kookic/VAL-2000/Media/cap-buttons-bottom.jpg

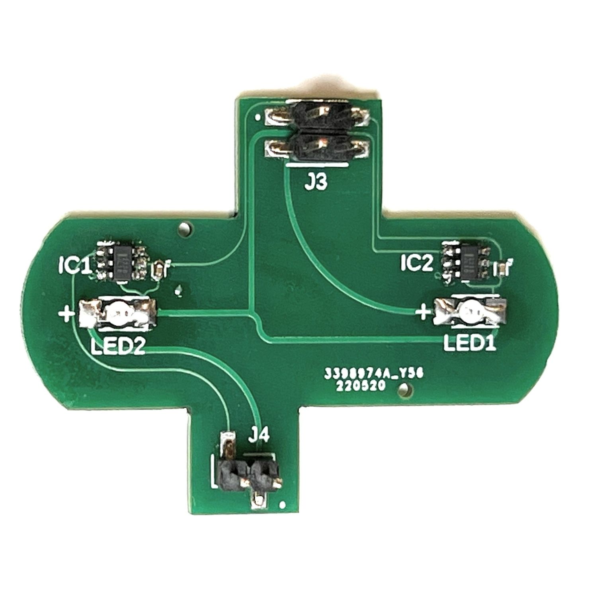
Media/cap-buttons-bottom.jpg
