kookic/VAL-2000/Media/cap-buttons-mounted-2.jpg

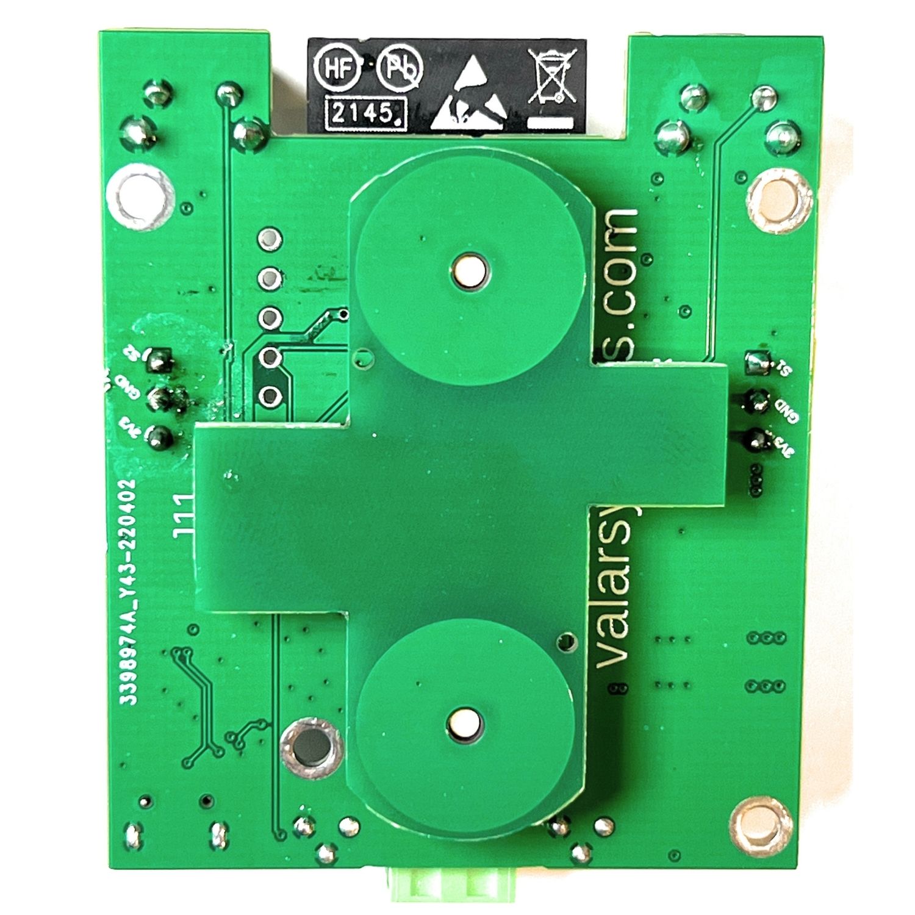
Media/cap-buttons-mounted-2.jpg
