kookic/VAL-2000/Media/cap-buttons-mounted.jpg

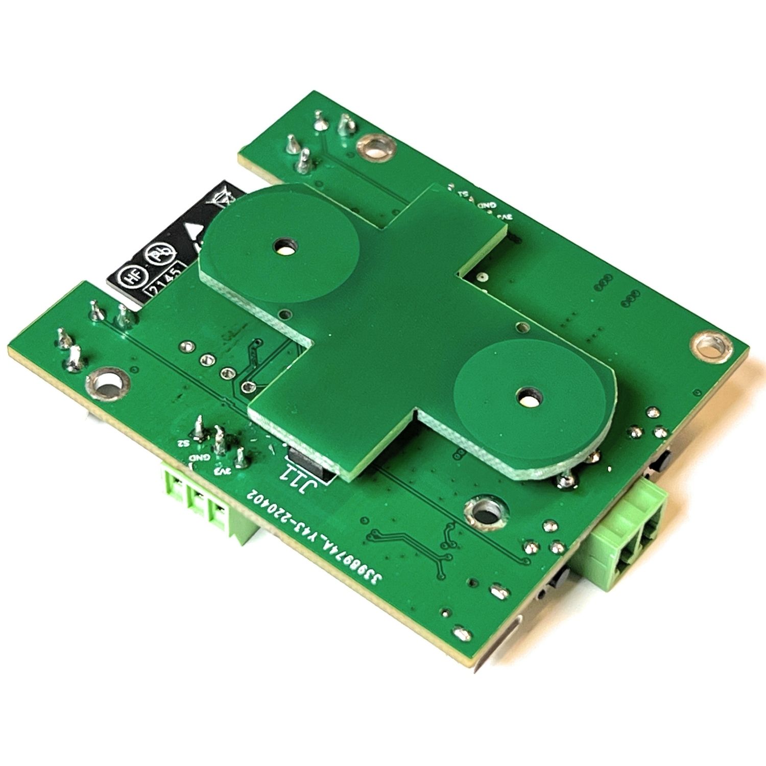
Media/cap-buttons-mounted.jpg
