kookic/VAL-2000/Media/VAL-2000-top.jpg

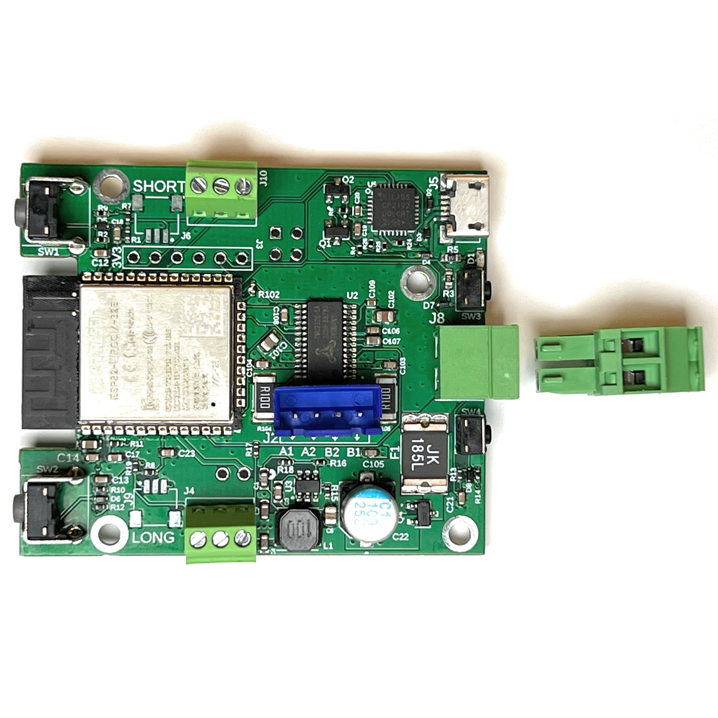
Media/VAL-2000-top.jpg
