kookic/VAL-2000/Schematic.pdf

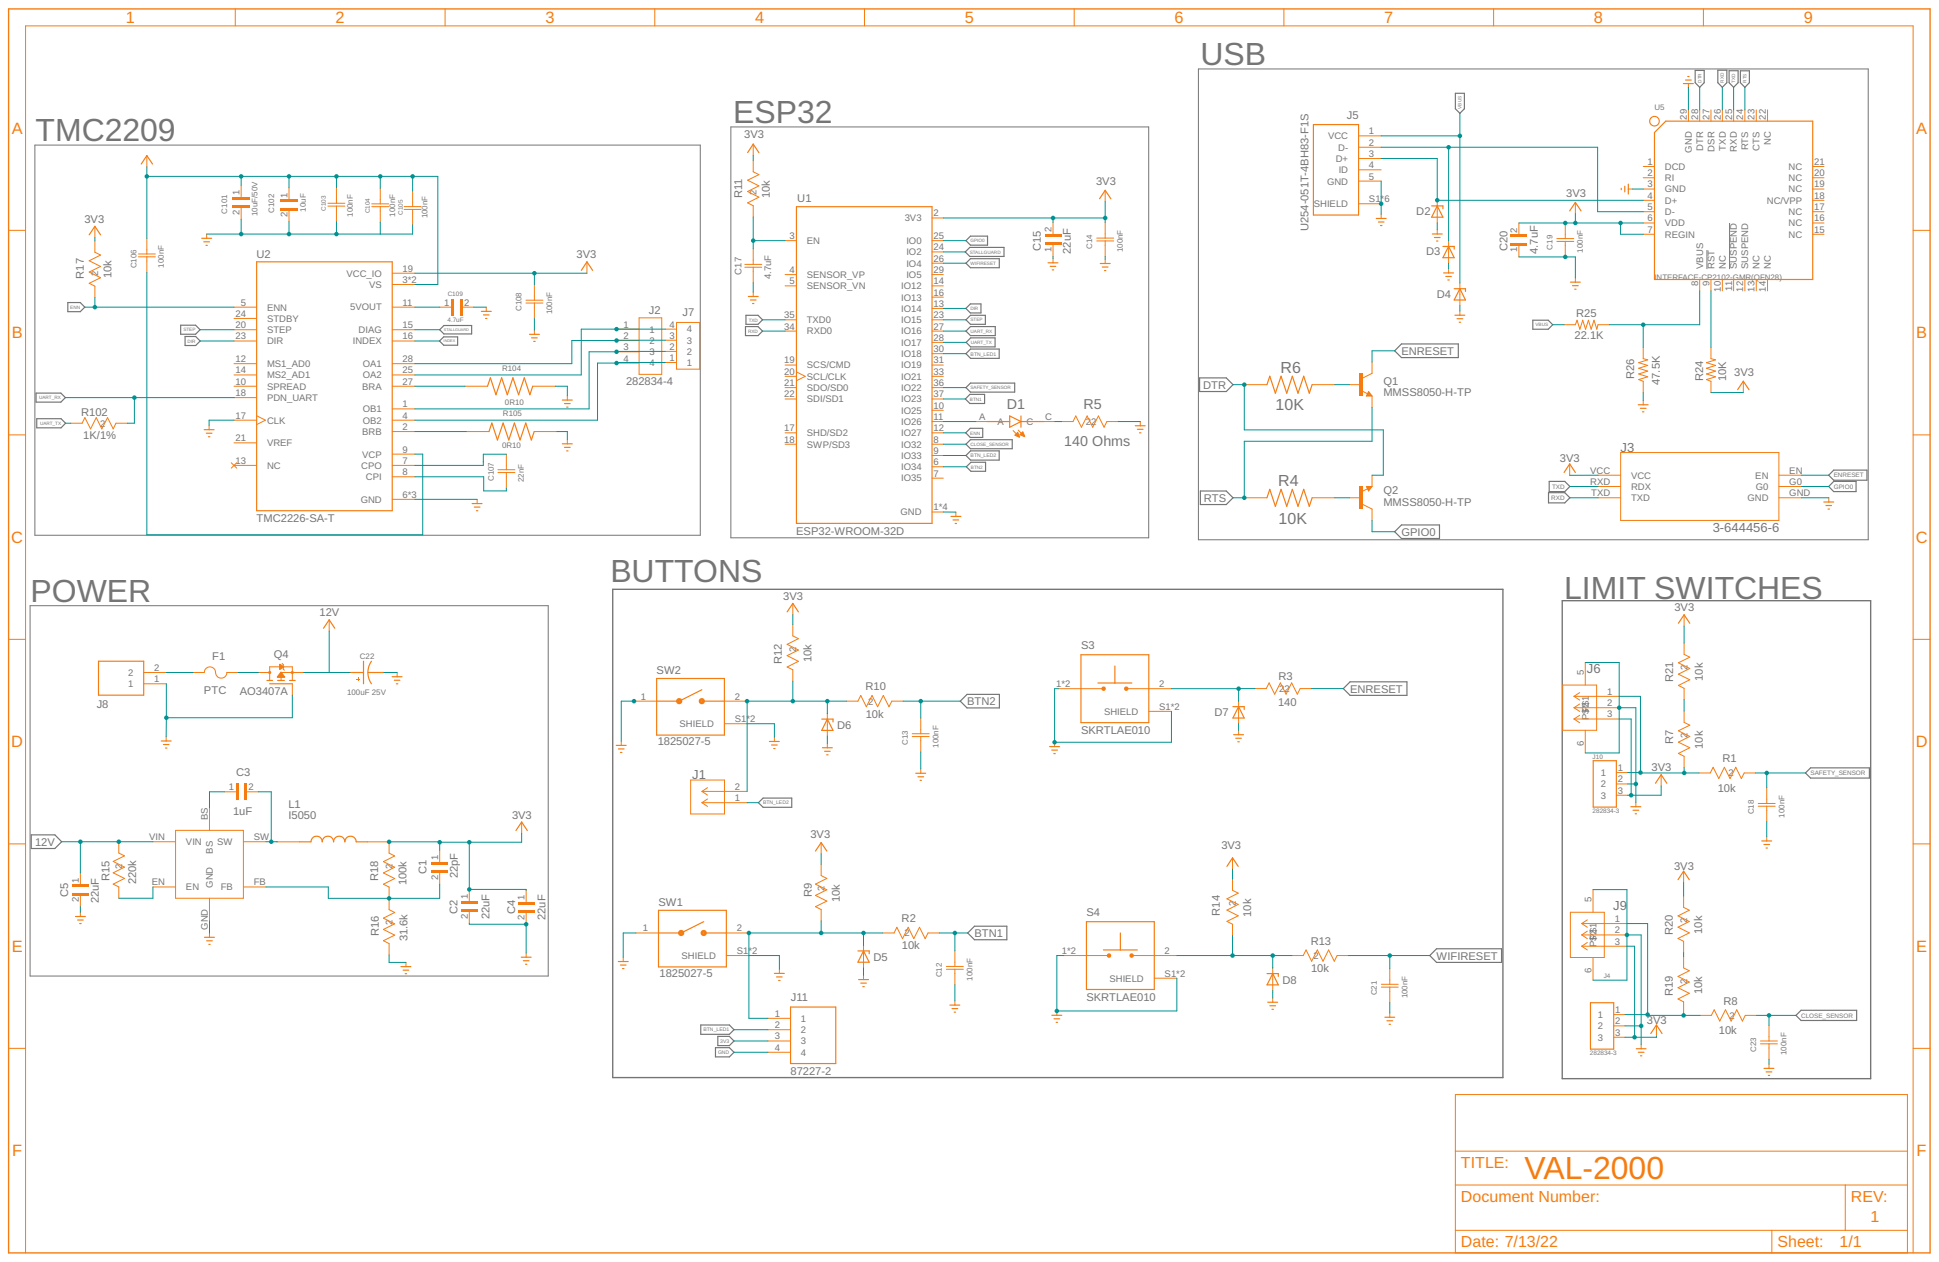
[picture p9: page 1]

1 GND 4 VCC

Document Number: | REV: 1

Date: 7/13/22 | Sheet: 1/1
